MisterDickson/SolarCharger/doc/PCB-Testpoints.png

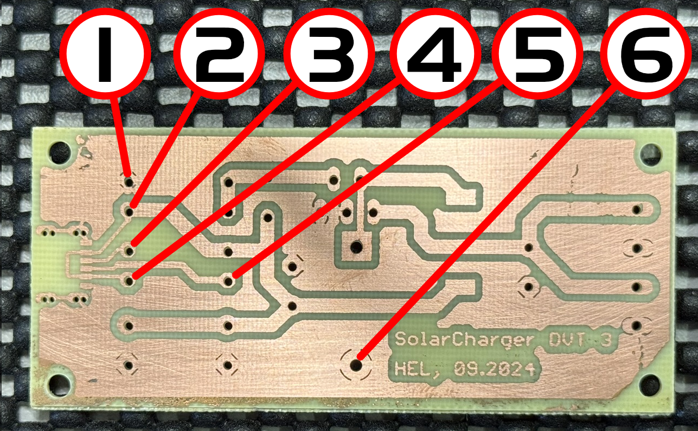
doc/PCB-Testpoints.png
