MisterDickson/SolarCharger/EAGLE-hel/SolarCharger.pdf

HEL 2024

## TESTPROTOKOLL

SolarCharger

Iteration: ______________ | Datum: ______________

– Leerlaufbetrieb –

Eingangsspannung: _______ | Ausgangsspannung: ____________
Stromaufnahme: __________ | Restwelligkeit: __________________

– Unter Last –

Belastung: ________________ Ausgangsspannung: ___________

Stromaufnahme: __________ Restwelligkeit: _________________

Notizen: __________________________________________________________________

___________________________________________________________________________

___________________________________________________________________________

___________________________________________________________________________

___________________________________________________________________________

___________________________________________________________________________

___________________________________________________________________________

___________________________________________________________________________

## BENOTUNG

SolarCharger

SEHR GUT – Selbstaendig die Schaltung gezeichnet und das Platinenlayout entworfen. Geraet funktioniert nach dem selbststaendigen Aufbau auf Anhieb. Umfangreiche Dokumentation der Schaltung und des Aufbaus.

GUT – Geraet funktioniert nach dem selbststaendigen Aufbau auf Anhieb; oder Fehler wurden selbststaendig erkannt und behoben.

BEFRIEDIGEND – Geraet funktioniert nicht. Fehler konnten nicht behoben werden. Dennoch solide Loetstellen.

GENUEGEND – Die Bauteile haben irgendwie ihren Weg auf die Platine gefunden. Mangelhafte Loetstellen.

NICHT GENUEGEND – Platine mangelhaft bestueckt.

## ARBEITSVORBEREITUNG

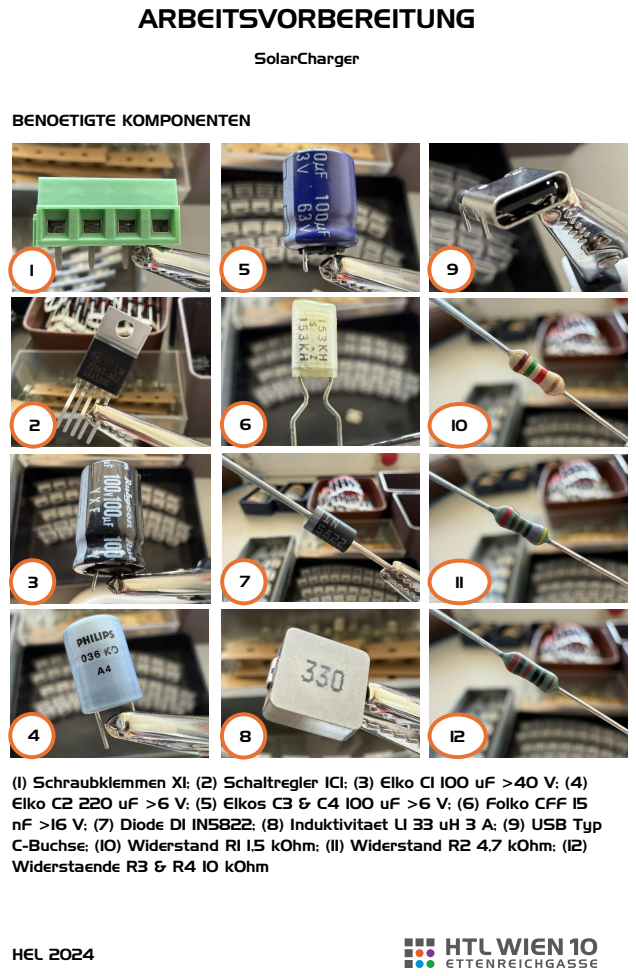
[picture p2: page 3]

(1) Schraubklemmen X1; (2) Schaltregler IC1; (3) Elko C1 100 uF >40 V; (4)
Elko C2 220 uF >6 V; (5) Elkos C3 & C4 100 uF >6 V; (6) Folko CFF 15
nF >16 V; (7) Diode D1 1N5822; (8) Induktivitaet L1 33 uH 3 A; (9) USB Typ
C-Buchse; (10) Widerstand R1 1,5 kOhm; (11) Widerstand R2 4,7 kOhm; (12)
Widerstaende R3 & R4 10 kOhm

## FERTIGUNGSANLEITUNG

SolarCharger

Visuelle Inspektion – Die sichtbaren Maengel der Leiterplatte beheben. Aufgerissene Leiterbahnen flicken und Kurzschluesse auftrennen.

Entsprechend folgender Matrix die Leiterplatte auf Durchgang und Isolation pruefen.

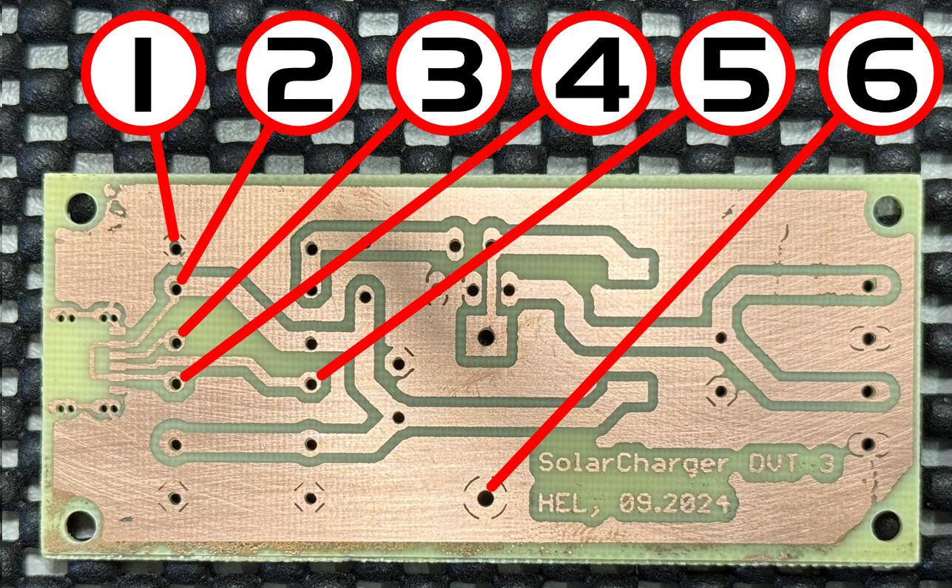
[picture p3: figure]

| 1 | 2 | 3 | 4 | 5 | 6
1 | | O.L | O.L | O.L | O.L | 0 Ohm
2 | O.L | | O.L | 0 Ohm | O.L | O.L
3 | O.L | O.L | | O.L | O.L | O.L
4 | O.L | 0 Ohm | O.L | | O.L | O.L
5 | O.L | O.L | O.L | O.L | | O.L
6 | 0 Ohm | O.L | O.L | O.L | O.L

Isolierendes Klebeband nach Naturmaß zuschneiden und damit die Flaechen unterhalb der USB-Buchse und der Induktivitaet bedecken. Loet-Augen und -Pads freihalten.

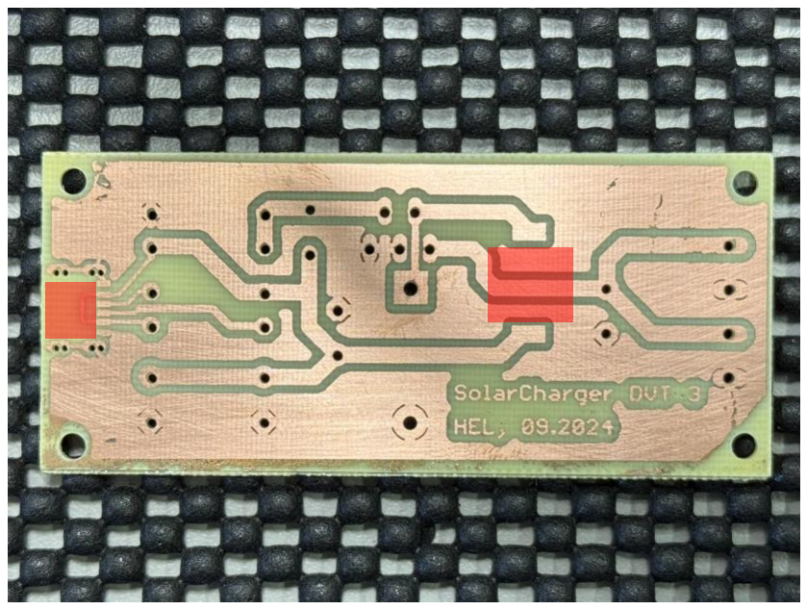
[picture p4: figure]
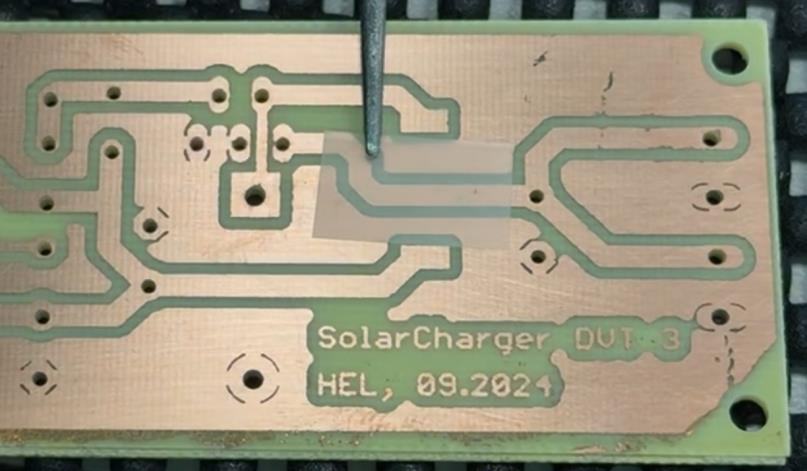
[picture p5: figure]

Die Loet-Laschen der USB-Buchse um 90 Grad nach außen biegen, sodass sie flach auf der Platine aufliegen.

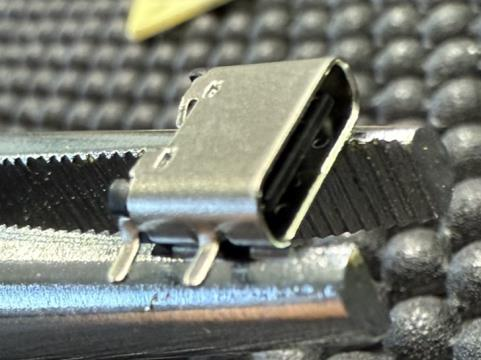
[picture p6: figure]

USB-Buchse auf der Platine so positionieren, dass die SMD-Anschluesse der Buchse mit den Loet-Pads der Platine ausgerichtet sind.

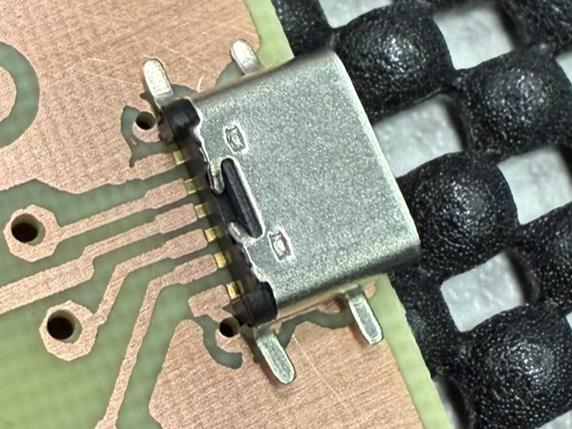
[picture p7: figure]

Das Gehaeuse der Buchse an einer Stelle loeten.

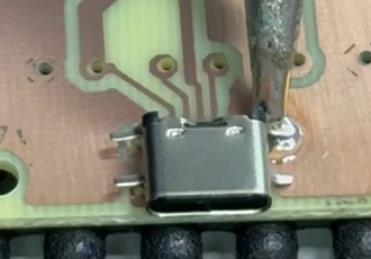
[picture p8: figure]
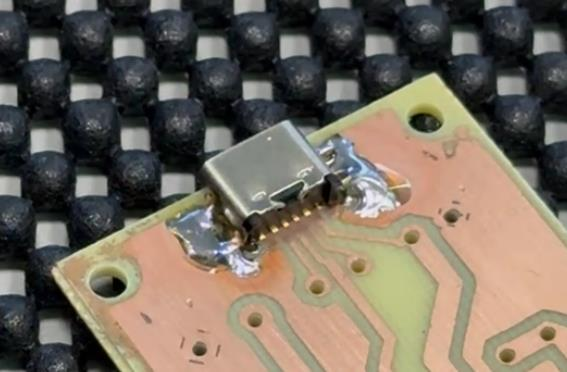
[picture p9: figure]

Sollten die Pads nicht mehr ausgerichtet sein: Die Loetstelle aufwaermen, die Buchse vorsichtig ausrichten und danach wieder abkuehlen lassen.

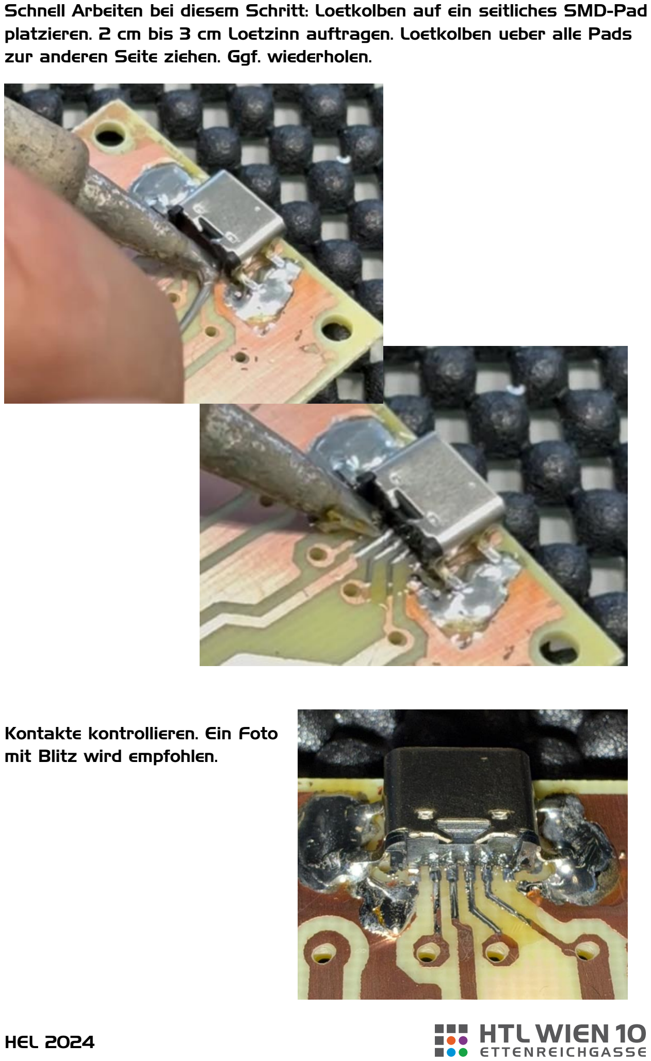
[picture p10: page 7]

Schnell Arbeiten bei diesem Schritt: Loetkolben auf ein seitliches SMD-Pad platzieren. 2 cm bis 3 cm Loetzinn auftragen. Loetkolben ueber alle Pads zur anderen Seite ziehen. Ggf. wiederholen.

Kontakte kontrollieren. Ein Foto mit Blitz wird empfohlen.

Kurzschluesse koennen behoben werden, indem der Loetkolben entlang den Leiterbahnen gezogen wird.

Nach Einbau der Buchse erneut Durchgaenge und Isolationen laut Matrix pruefen!

Induktivitaet mit der Platine verloeten.

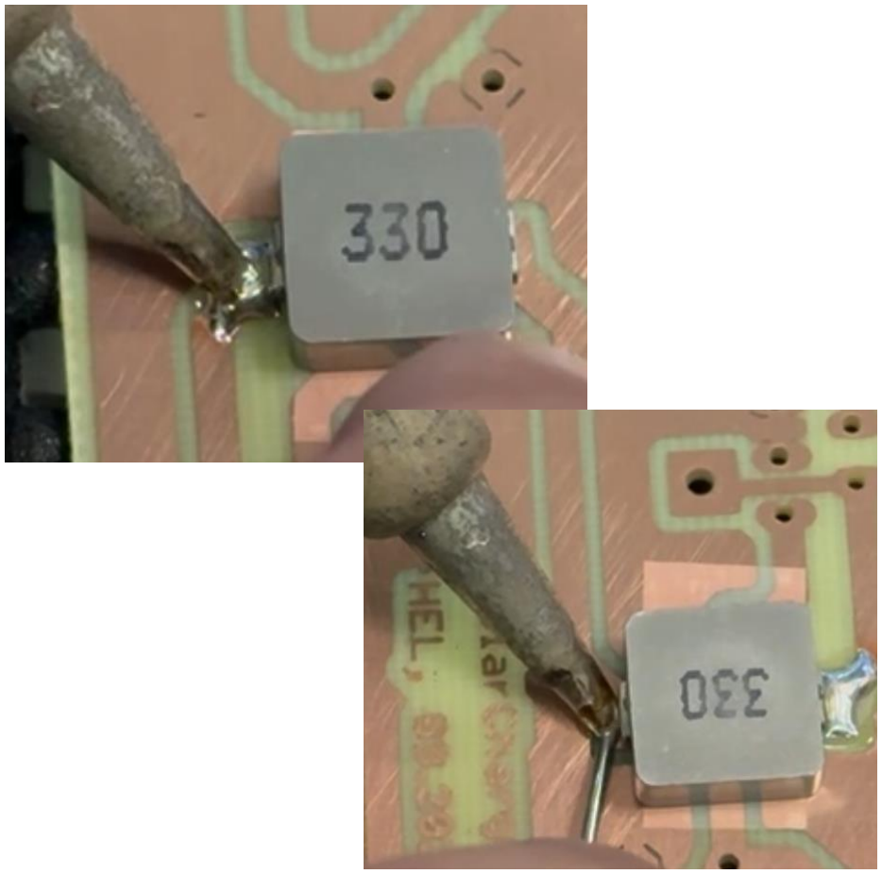
[picture p11: figure]

Erneut Durchgaenge und Isolationen laut Matrix pruefen!

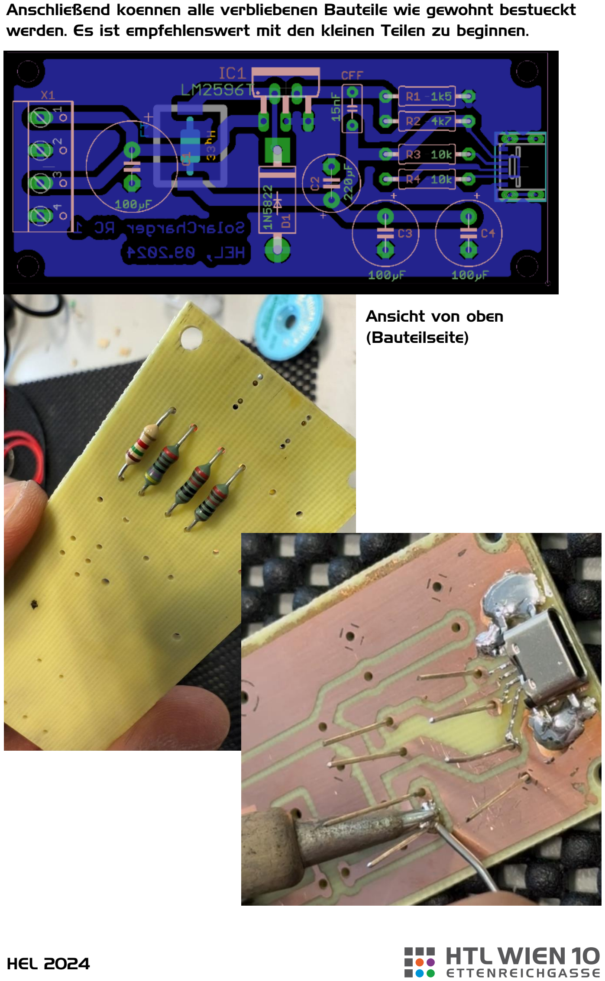
[picture p12: page 9]

Anschließend koennen alle verbliebenen Bauteile wie gewohnt bestueckt werden. Es ist empfehlenswert mit den kleinen Teilen zu beginnen.

Ansicht von oben
(Bauteilseite)

## TECHNISCHE DOKUMENTATION

SolarCharger

Die aktuellen Unterlagen sind unter https://github.com/MisterDickson/SolarCharger abrufbar.

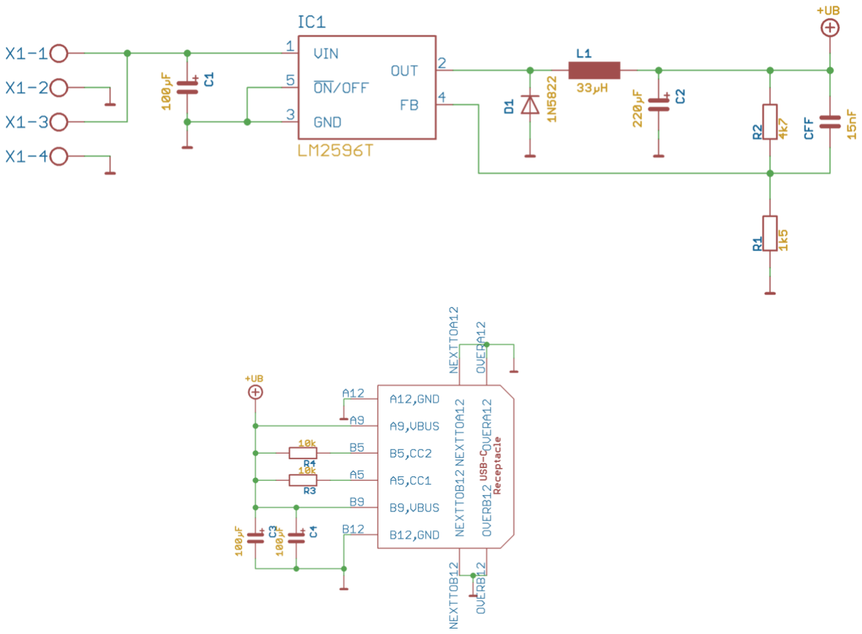
[picture p13: figure]

Das Geraet basiert auf eine Grundschaltung des LM2596T-Reglers. In dieser Schaltung wurde die Variante vom Regler mit der variablen Ausgangsspannung verwendet. In den meisten Faellen ist diese Schaltung auf der ersten Seite des Datenblattes zu finden. Das Geraet kann versorgt werden mit einer Gleichspannung von rund 7 Volt bis 40 Volt, wodurch der Betrieb mit Solarzellen geeignet ist. Der Ausgang des IC1 „+UB“ wird auf 5 Volt mit bis zu 3 Ampere geregelt.

Mit der Ausgangsspannung des Schaltreglers +UB wird eine USB Typ C-Buchse versorgt. Die Pins A9 und B9 sind miteinander verbunden, wodurch das USB-Kabel in beiden Orientierungen angeschlossen werden kann. Die Reihen A und B repraesentieren jeweils eine von zwei Seiten eines Symmetrischen Anschlusses.

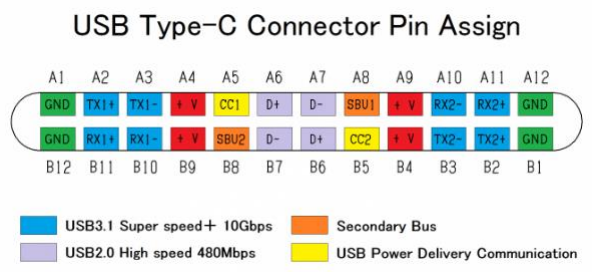
[picture p14: figure]

https://electronics.stackexchange.com/

Fuer die meisten Endgeraete reicht es aus, wenn an den Pins A9 oder B9 fuenf Volt anliegen, um einen Ladevorgang zu starten. Dieser Ladevorgang erlaubt jedoch nur einen Maximalstrom von einem Ampere, also 5 Watt. Fuer groeßere Leistungen muss vom USB Power Delivery-Protokoll (USB PD) Gebrauch gemacht werden. Damit kann dem Endgeraet mitgeteilt werden, wie viel Leistung zur Verfuegung steht. In diesem Fall sollen 3 A bei 5 V ans Endgeraet angeboten werden, also 15 Watt. Hierfuer reicht es aus, die „Configuration Channel“-Pins CC1 und CC2 ueber jeweils 10 kOhm an die 5 Volt „+UB“ zu haengen.

Genauere Informationen zu USB PD sind zu finden unter https://community.infineon.com/t5/Knowledge-Base-Articles/USB-Type-Cconnector-Rp-Rd-and-Ra-termination-resistors/ta-p/253544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. (https://community.infineon.com/t5/Knowledge-Base-Articles/USB-Type-C-connector-Rp-Rd-and-Ra-termination-resistors/ta-p/253544)

https://www.ti.com/lit/wp/slyy109b/slyy109b.pdf

sowie https://usb.org/documents

Verbraucher, also angeschlossene Endgeraete wie z.B. Smartphones werden als Upstream Facing Port (UFP) bezeichnet. Versorger wie z.B. Powerbanks oder dieses Ladegeraet werden als Downstream Facing Port (DFP) bezeichnet. Diese Rollen teilen die Geraete einander mit, wenn sie mit einem USB-Kabel verbunden werden.

Damit ein UFP als solches erkennbar ist, haengt sein CC-Pin ueber
5.1 kOhm auf Masse. Dieser Pull Down-Widerstand wird meistens als „Rd“ bezeichnet. Dieser Wert ist konstant.

Ein DFP teilt seine Rolle am selben CC-Pin durch einen Pull Up-Widerstand „Rp“ mit. Dieser Wert ist variabel, abhaengig von der Leistung, die ein DFP ausgeben kann.

Wenn zwei USB-Geraete miteinander verbunden werden, treffen sich der Rp vom DFP und der Rd vom UFP am CC-Pin und bilden dadurch einen Spannungsteiler.

Anhand der Spannung, die sich am CC-Pin ergibt, weiß der UFP wie viel Leistung aufgenommen werden kann.

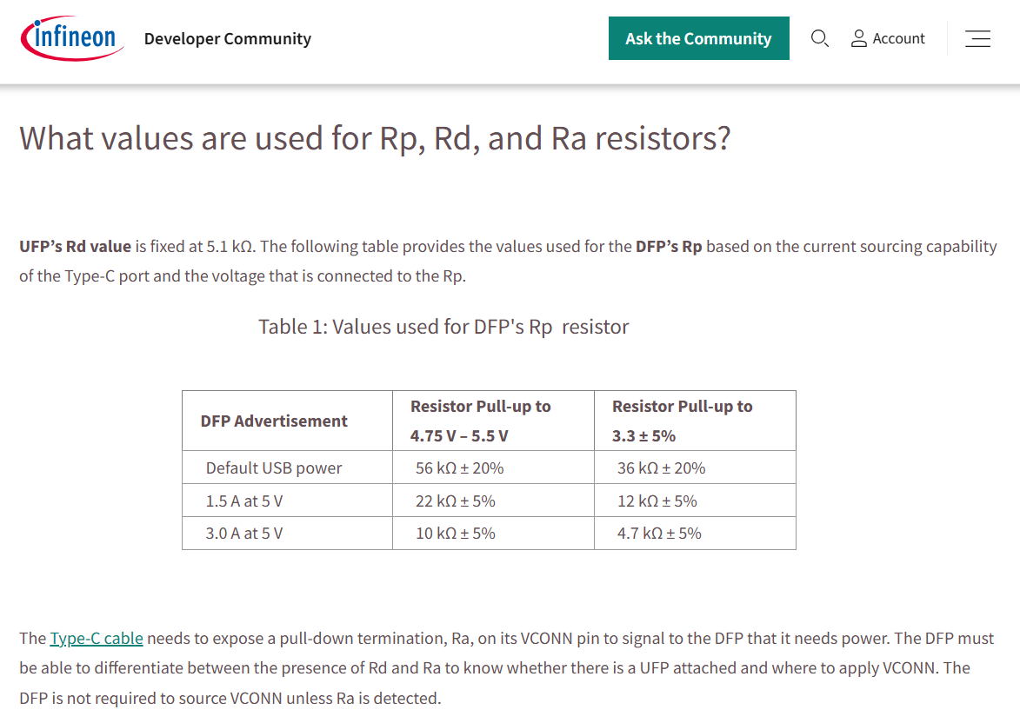
[picture p15: figure]

Das Layout entspricht nicht zwingend dem Datenblatt, funktioniert aber trotzdem.

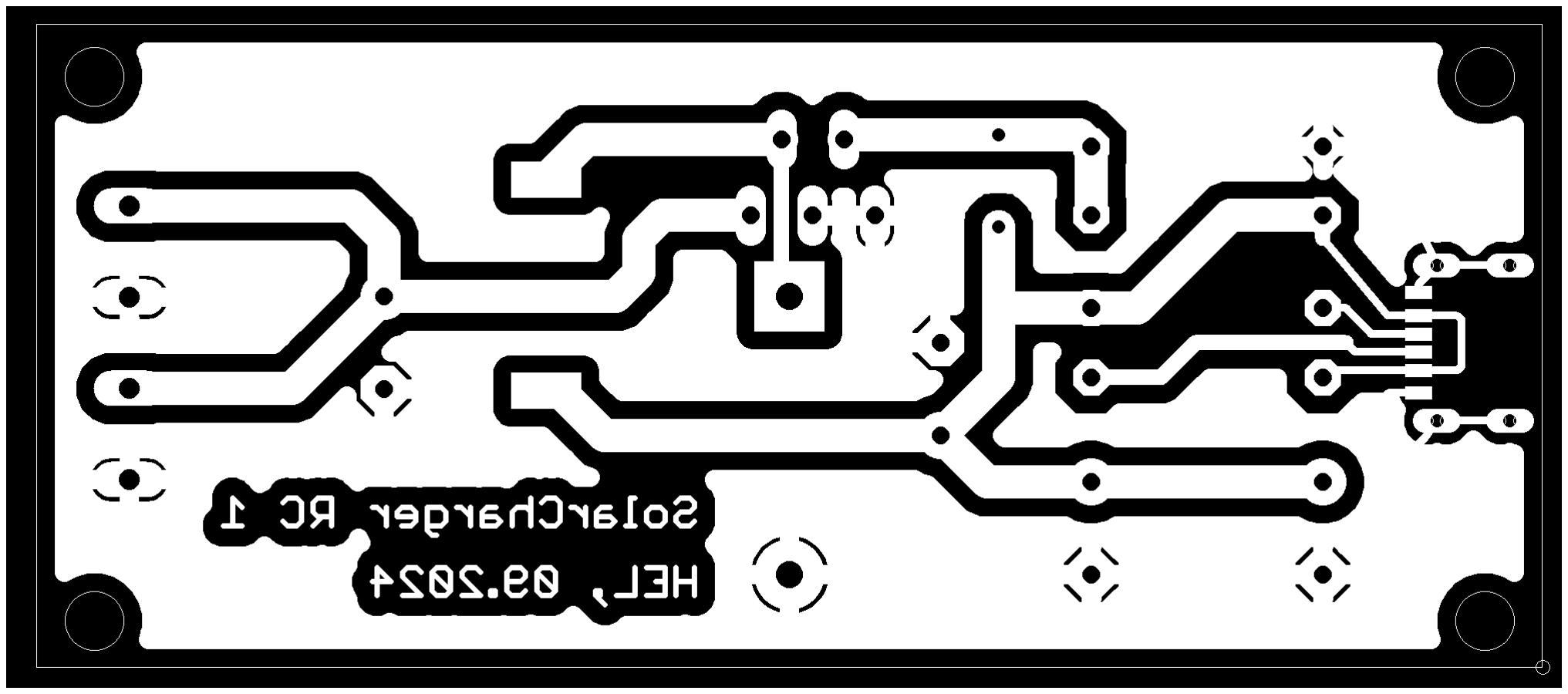
[picture p16: figure]
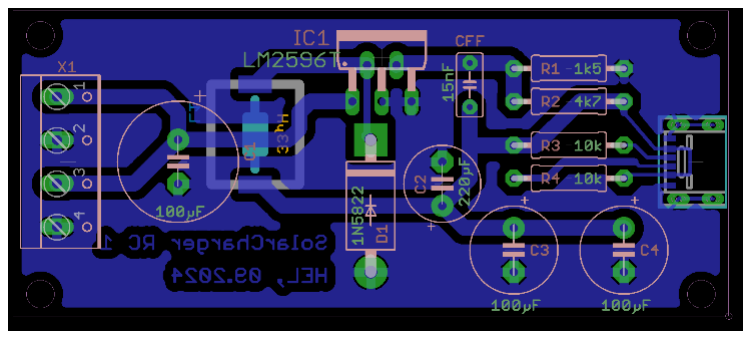
[picture p17: figure]

Der Kuehlkoerper fuer den IC kann aus Blech(-Resten) mit einer Staerke bis 3 mm gefertigt werden. Die Maße sind in Millimeter angegeben.

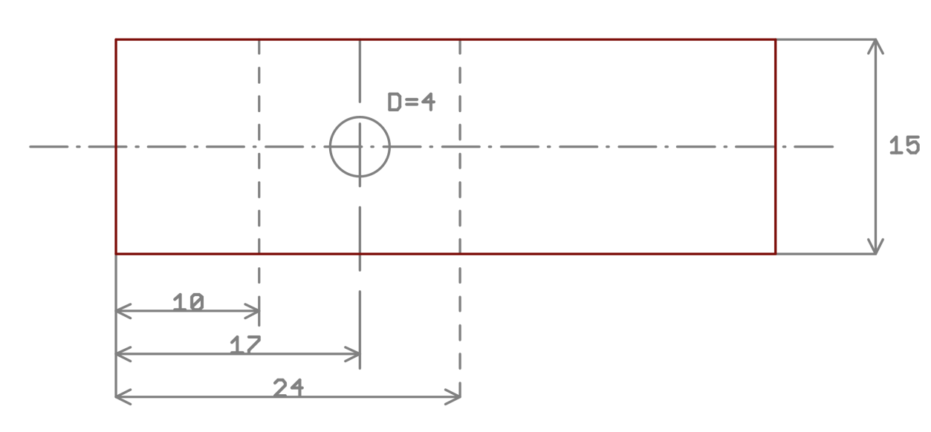
[picture p18: figure]

Partlist

Exported from SolarCharger.sch at 25.09.2024 09:10:29

EAGLE Version 5.12.0 Copyright (c) 1988-2011 CadSoft

Part | Value | Device | Package | Library
C1 | 100µF | CPOL-EUE5-13 | E5-13 | HTL-RCL
C2 | 220µF | CPOL-EUE5-8.5 | E5-8,5 | HTL-RCL
C3 | 100µF | CPOL-EUE5-10.5 | E5-10,5 | HTL-RCL
C4 | 100µF | CPOL-EUE5-10.5 | E5-10,5 | HTL-RCL
CFF | 10nF | C-EU050-030X075 | C050-030X075 | HTL-RCL
D1 | 1N5822 | 1N5624 | DO201-15 | HTL-diode
IC1 | LM2596T | LM2596T | T05D | national-
semiconductor
L1 | 33µH | L | AMRM00101040 | hel-diverses
R1 | 1k5 | R-EU_0309/12MM-5E 0309/12 | HTL-RCL
R2 | 4k7 | R-EU_0309/12MM-5E 0309/12 | HTL-RCL
R3 | 10k | R-EU_0309/12MM-5E 0309/12 | HTL-RCL
R4 | 10k | R-EU_0309/12MM-5E 0309/12 | HTL-RCL
U$1 | USB-C-RECEPTACLE USB-C-RECEPTACLE 6-PIN-USB-C-RECEPTACLE hel-diverses
X1 | | W237-4 | W237-4 | con-wago-500

## EINVERSTAENDNISERKLAERUNG

SolarCharger

Haftungsausschluss fuer USB-C Solar-Netzteil

Dieses Werkstueck wurde ausschließlich zu Ausbildungszwecken hergestellt und entspricht nicht den Sicherheits- oder Qualitaetsstandards handelsueblicher elektronischer Geraete. Es wurde keine kommerzielle Pruefung oder Zertifizierung vorgenommen.

Verwendung durch Schueler:

Die Inbetriebnahme und Verwendung dieses Werkstuecks ist nur fuer den Unterricht vorgesehen. Eine Nutzung außerhalb der Schule, insbesondere durch Personen ohne entsprechende elektrotechnische Ausbildung, ist strengstens untersagt. Eine gewerbliche Nutzung oder Weitergabe des Werkstuecks ist verboten.

Gefahrenhinweis:

Die unsachgemaeße Verwendung des Werkstuecks kann zu ernsthaften Schaeden fuehren, darunter:

- Zerstoerung des angeschlossenen Endgeraets
- Brandgefahr
- Koerperverletzungen durch elektrische Defekte

Haftungsausschluss:

Fuer jegliche Schaeden oder Verletzungen, die aus der Nutzung dieses Werkstuecks resultieren, wird keinerlei Haftung übernommen. Jegliche Verwendung erfolgt ausschließlich auf eigenes Risiko.

Bestaetigung der Erziehungsberechtigten:

Ich, _______________________________ (Name der erziehungsberechtigten Person), vertretend als erziehungsberechtigte Person fuer den Schueler _______________________, geboren am ___________, erklaere hiermit, dass ich ueber die Gefahren der Nutzung dieses Werkstuecks informiert wurde und die Haftungsbeschraenkungen anerkenne.

Bestaetigung des Schuelers (falls volljaehrig):

Ich, _______________________________, geboren am _____________, bestaetige hiermit, dass ich ueber die Gefahren und Haftungsbeschraenkungen aufgeklaert wurde und mir dieser bewusst bin.

__________________ | __________________
Ort, Datum | Unterschrift
