MisterDickson/SolarCharger/EAGLE-hel/SolarCharger-Circuit.png

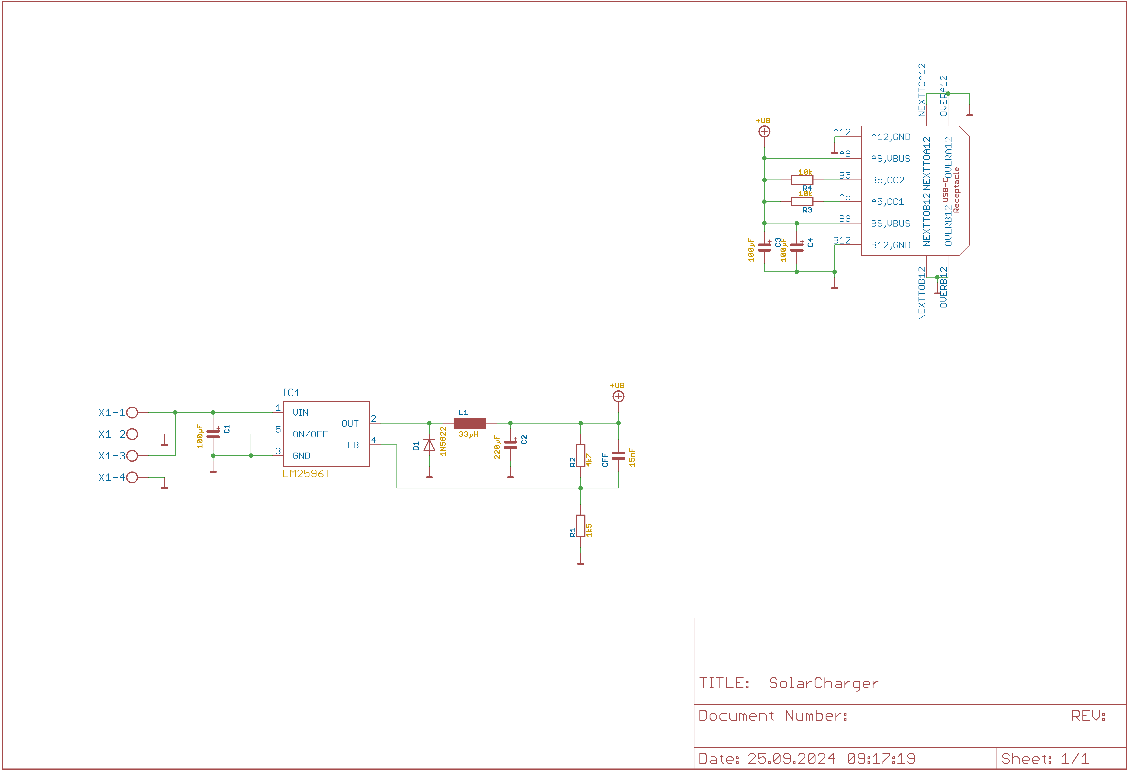
EAGLE-hel/SolarCharger-Circuit.png
