MisterDickson/SolarCharger/fabrication/Heatsink.pdf

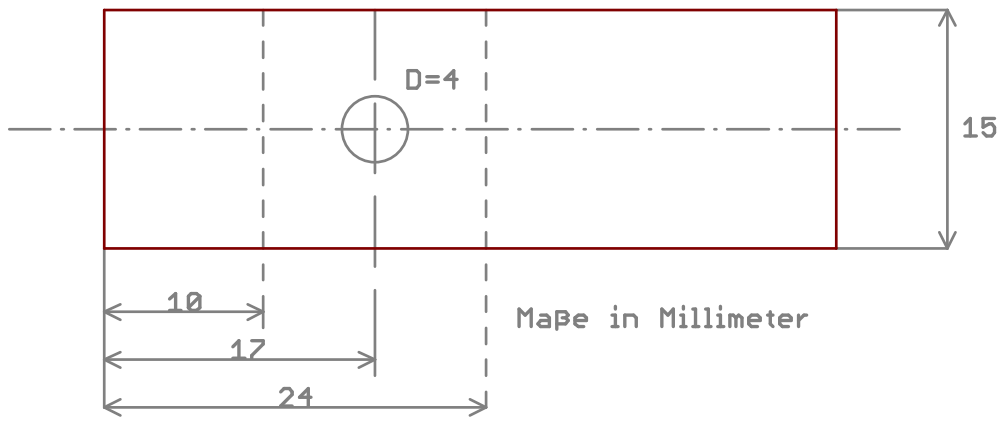
[picture p20: page 1]
