MisterDickson/SolarCharger/fabrication/Layer.pdf

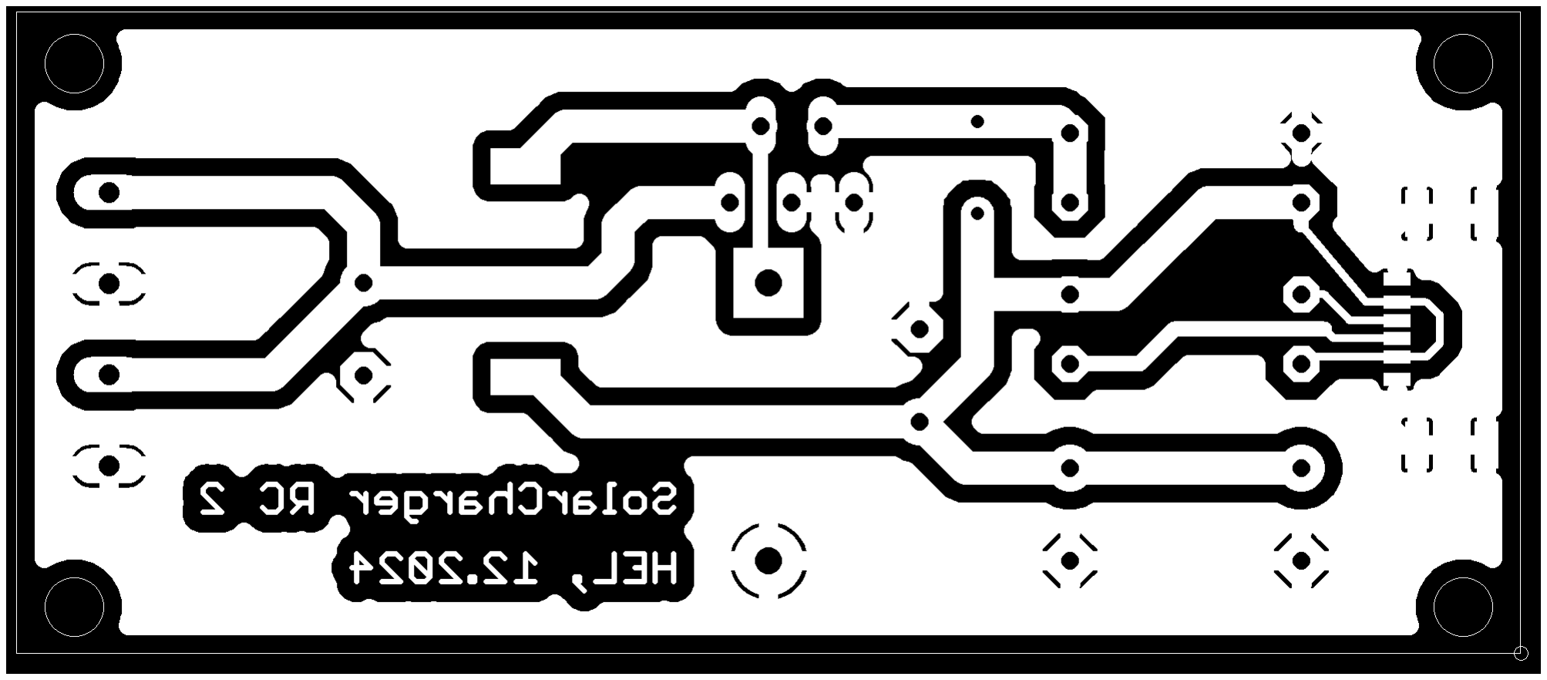
[picture p21: figure]
