MisterDickson/SolarCharger/(commit log)

2024-09-25 add CFF value of 15nF
    [SolarCharger.brd, SolarCharger.sch]
2024-09-25 update doc
    [Kuehlkoerper.sch, SolarCharger.brd, SolarCharger.sch]
2024-12-09 RC 2
    lbr: remove incompatible drill holes
    schematic: replace usb port from lbr, change diode to similar but available part
    board: replace usb port, update text
    fabrication: update bottom layer
    add sheet number in parts list for "+UB"
    [SolarCharger.brd, SolarCharger.sch]
